grahamwhaley/ArduinoISP-pico/schematic/README.md

I always forget how to generate a nice PNG from the KiCad schematic, so here are some hints:

  - Export (plot) the schematic as an SVG
  - Load that SVG into inkscape
  - Set the background colour transparency (Alpha) to 0xff, rather than the default 0x00
  - Export the PNG from InkScape
