grahamwhaley/ArduinoISP-pico/schematic/ArduinoISP-pico.sch

## KiCad design schematic/ArduinoISP-pico.sch (2024-03-12)

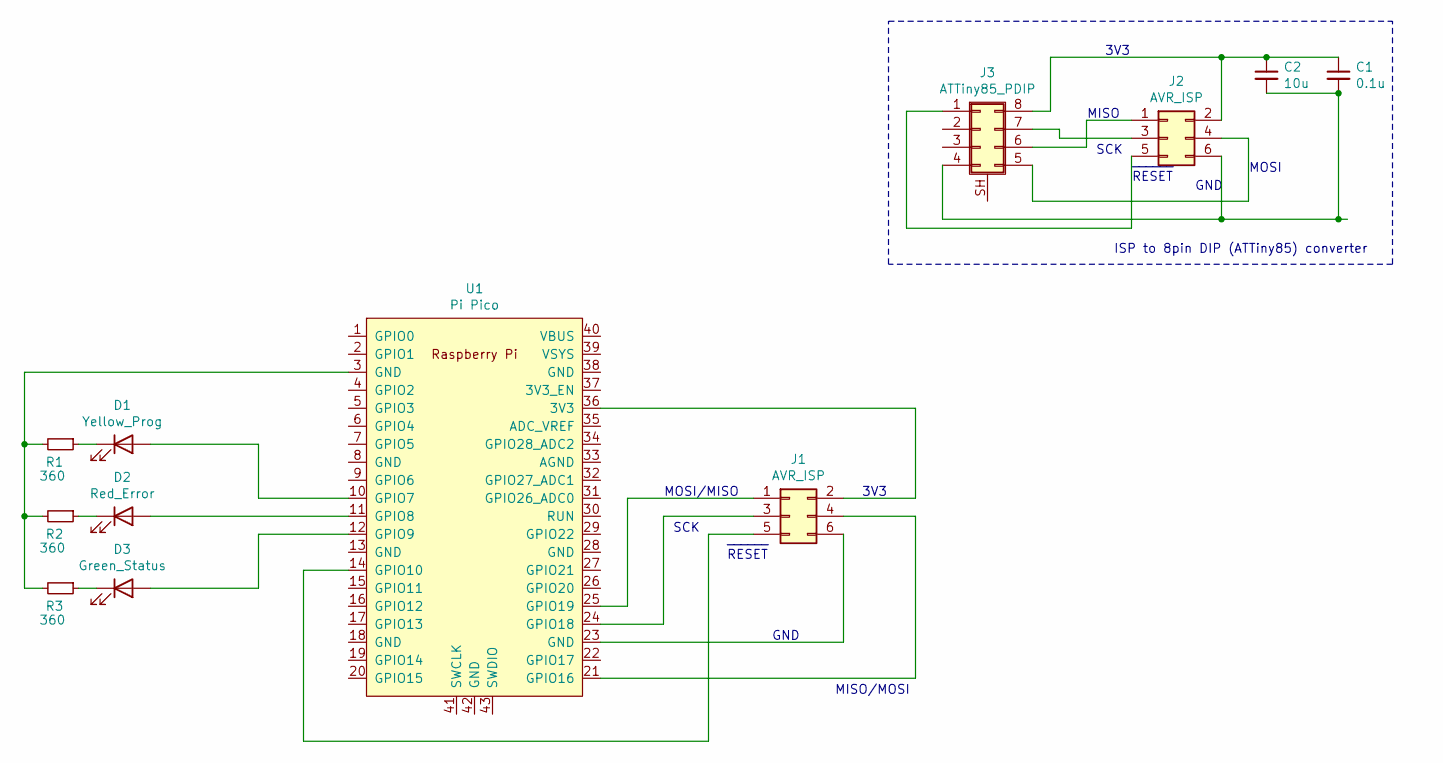
[picture p4: schematic ArduinoISP-pico.sch]

Parts:
C1: 0.1u
C2: 10u
D1: Yellow_Prog
D2: Red_Error
D3: Green_Status
J1, J2: AVR_ISP
J3: ATTiny85_PDIP
R1, R2, R3: 360
U1: Pi Pico; RPi_Pico_SMD_TH

Connections:
unnamed: C1.1, C2.1, J2.2, J3.8
unnamed: C1.2, C2.2, J2.6, J3.4
unnamed: D1.1 (K), R1.1
unnamed: D1.2 (A), U1.10 (GPIO7)
unnamed: D2.1 (K), R2.1
unnamed: D2.2 (A), U1.11 (GPIO8)
unnamed: D3.1 (K), R3.1
unnamed: D3.2 (A), U1.12 (GPIO9)
unnamed: J1.1, U1.25 (GPIO19)
unnamed: J1.2, U1.36 (3V3)
unnamed: J1.3, U1.24 (GPIO18)
unnamed: J1.4, U1.21 (GPIO16)
unnamed: J1.5, U1.14 (GPIO10)
unnamed: J1.6, U1.23 (GND)
unnamed: J2.1, J3.6
unnamed: J2.3, J3.7
unnamed: J2.4, J3.5
unnamed: J2.5, J3.1
unnamed: R1.2, R2.2, R3.2, U1.3 (GND)

Notes on the sheet:
______ RESET
SCK
MOSI/MISO
3V3
GND
MISO/MOSI
MOSI
MISO
ISP to 8pin DIP (ATTiny85) converter
