grahamwhaley/ArduinoISP-pico/(commit log)

2024-03-12 Initial commit: Schematic and details
    Add the schematic, pictures, documentation and mildly modified .ino
    to the repository.
    [ArduinoISP-pico.sch]
2024-05-04 README: Fix a few typos
    Spotted a couple of typos. Clean them up.
